DJTobias/UAS_receiver_design/receiver7RP2350V5/receiver_assembly/receiver_panelized/Screenshot from 2025-09-17 13-29-44.png

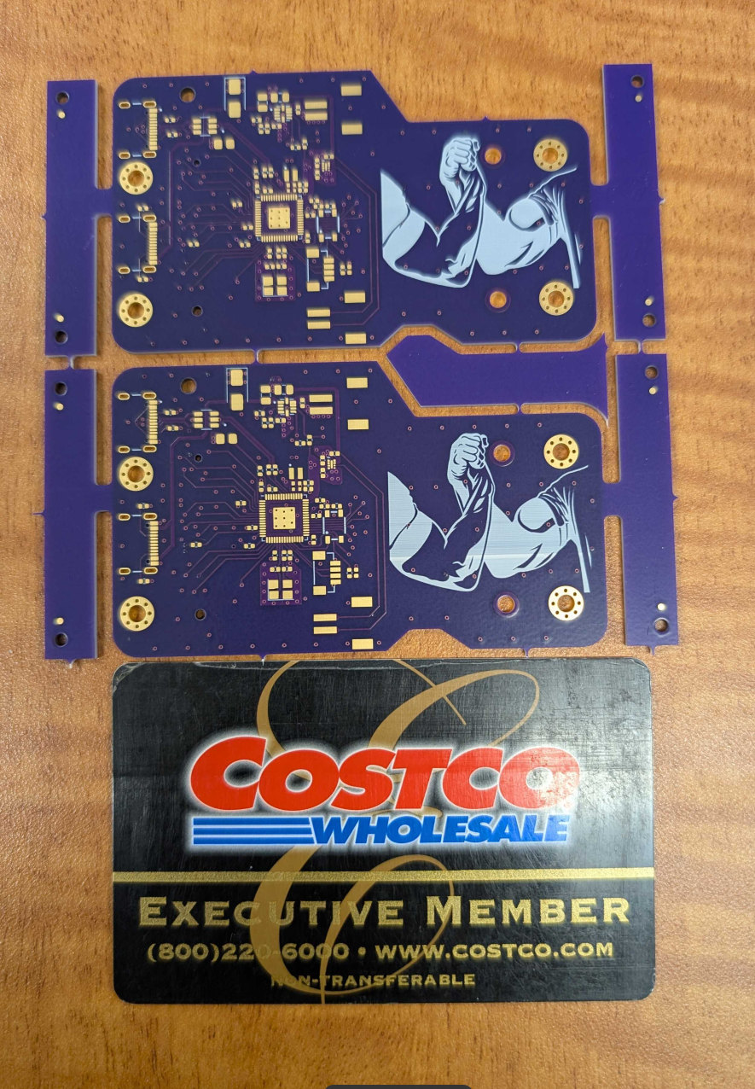
receiver7RP2350V5/receiver_assembly/receiver_panelized/Screenshot from 2025-09-17 13-29-44.png
