DJTobias/UAS_receiver_design/receiver7RP2350V4/receiver_assembly/receiverV4/R4_BOM.xlsx

ITEM # | QUANTITY | REF Des | Description/Value | Mfg Part NUM | Manufacturer | Sourcing | Type | URL/Datasheet
1 | 2 | C20,C21 | CAP CER 15PF 5% 16V 0402 | GJM1555C1H150FB01D | Murata | Vendor source | SMT | https://octopart.com/gjm1555c1h150fb01d-murata-17965865
2 | 2 | C26,C30 | CAP CER 10UF 10% 50V X5R 0805 | GRM21BR61H106KE43L | Murata | Vendor source | SMT | https://octopart.com/grm21br61h106ke43l-murata-52808131
3 | 10 | C3,C6,C7,C9,C10,C15,C22,C23,C27,C28 | CAP CER 4.7UF 10% 10V X5R 0402 | C1005X5R1A475K050BC | TDK | Vendor source | SMT | https://octopart.com/c1005x5r1a475k050bc-tdk-28166959
4 | 15 | C1,C2,C4,C5,C8,C11,C12,C13,C14,C16,C17,C18,C24,C25,C31 | CAP CER 100NF 10% 16V X5R 0402 | CC0402KRX5R7BB104 | Yageo Group | Vendor source | SMT | https://octopart.com/cc0402krx5r7bb104-yageo+group-8376508
5 | 1 | D1 | LED, RED, 0402 | XZMDK68W-2 | SunLED | Vendor source | SMT | https://octopart.com/xzmdk68w-2-sunled-39188860
6 | 1 | D2 | Transient Voltage Suppressor, 6.0V bidirectional, SMA(DO-214AC) | SMAJ6.0CA | Littlefuse | Vendor source | SMT | https://octopart.com/smaj6.0ca-littelfuse-350218
7 | 1 | J1 | JST SH CONN 4pin 1mm spaceing | BM04B-SRSS-TB | JST | Vendor source | SMT | https://octopart.com/bm04b-srss-tb-jst-289151
8 | 2 | J2,J3 | MM60 Stand Off | NT4R1600 | JAE Electronics | Vendor source | SMT | https://octopart.com/nt4r1600-jae+electronics-20362796
9 | 1 | J6 | Conn Mini PCI Express Card Edge SKT 52 POS 0.8mm | MM60-52B1-E1-R650 | JAE Electronics | Vendor source | SMT | https://octopart.com/mm60-52b1-e1-r650-jae+electronics-9561106
10 | 2 | J8,J10 | JST PH CONN 2pin 2mm spacing RIGH ANG | S2B-PH-SM4-TB | JST | Vendor source | SMT | https://octopart.com/s2b-ph-sm4-tb-jst-52244065
11 | 2 | J5,J7 | USB Connector, 24 Contact(s), Female, Right Angle, Solder Terminal, Locking | USB4105-GF-A | Global Connector Technology | Vendor source | SMT | https://octopart.com/usb4105-gf-a-global+connector+technology-107467269
12 | 1 | L1 | IND 3.3uH, 2.3A, 20% | AOTA-B201610S3R3-101-T | Abracon | Vendor source | SMT | https://octopart.com/aota-b201610s3r3-101-t-abracon-159358662
13 | 1 | R20 | RES 330k Ohm 1% 1/16W 0402 | CRCW0402330KFKED | Vishay | Vendor source | SMT | https://octopart.com/crcw0402330kfked-vishay-39868742
14 | 2 | R18, R21 | RES 100k Ohm 1& 1/16W 0402 | CRCW0402100KFKED | Vishay | Vendor source | SMT | https://octopart.com/crcw0402100kfked-vishay-39455035
15 | 2 | R12,R13 | RES 10k Ohm 1% 1/16W 0402 | CRCW040210K0FKEDHP | Vishay | Vendor source | SMT | https://octopart.com/crcw040210k0fkedhp-vishay-44321076
16 | 4 | R8,R10,R15,R16 | RES 5.1k Ohm 1% 1/16W 0402 | CRCW04025K10FKED | Vishay | Vendor source | SMT | https://octopart.com/crcw04025k10fked-vishay-39831117
17 | 2 | R14,R19 | RES 3.3k Ohm 5% 1/16W 0402 | CRCW04023K30JNEDC | Vishay | Vendor source | SMT | https://octopart.com/crcw04023k30jnedc-vishay-23798202
18 | 4 | R1,R2,R6,R11 | RES 1k Ohm 5% 1/16W 0402 | CRCW04021K00FKED | Vishay | Vendor source | SMT | https://octopart.com/crcw04021k00fked-vishay-39455913
19 | 1 | R7 | RES 33 Ohm 1% 1/5W 0402 | CRCW040233R0FKEDHP | Vishay | Vendor source | SMT | https://octopart.com/crcw040233r0fkedhp-vishay-44383092
20 | 2 | R3,R4 | RES 27 Ohm 1% 1/5W 0402 | CRCW040227R0FKEDHP | Vishay | Vendor source | SMT | https://octopart.com/crcw040227r0fkedhp-vishay-44387812
21 | 1 | S1 | Tactile Switch, 0.05A, 16Vdc, | 434133025816 | Wurth Elektronik | Vendor source | SMT | https://octopart.com/434133025816-wurth+elektronik-99472342
22 | 1 | U1 | RP2354 60-QFN (7x7) SC | SC1511 | Rasberry Pi | Vendor source | SMT | https://www.digikey.com/en/products/detail/raspberry-pi/SC1511-A4/28172162
23 | 1 | U2 | USBLC6-2SC6 | USBLC6-2SC6 | STMicroelectronics | Vendor source | SMT | https://octopart.com/usblc6-2sc6-stmicroelectronics-39666276
24 | 1 | U5 | 3.3V, 1 A, LDO Regulator, XDFN8-1216 | NCP186AMX330TAG | Onsemi | Vendor source | SMT | https://octopart.com/ncp186amx330tag-onsemi-61522627
25 | 1 | U4 | MP2664GG-0000-Z | MP2664GG-0000-Z | Monolithic Power Systems | Vendor source | SMT | https://octopart.com/mp2664gg-0000-z-monolithic+power+systems-105831035
26 | 1 | Y1 | Crystal Oscillator 12MHz | ABM8-272-T3 | Abracon | Vendor source | SMT | https://octopart.com/abm8-272-t3-abracon-145972461
