DJTobias/UAS_receiver_design/receiver7RP2350V5/receiver_assembly/receiver_files_v2/receiver_top_image.png

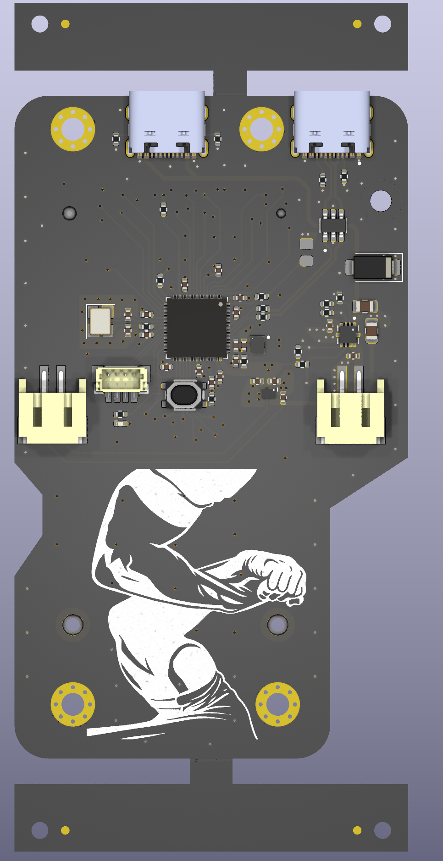
receiver7RP2350V5/receiver_assembly/receiver_files_v2/receiver_top_image.png
