DJTobias/UAS_receiver_design/receiver7RP2350V5/receiver_assembly/receiver/receiver7RP2350V5.pdf

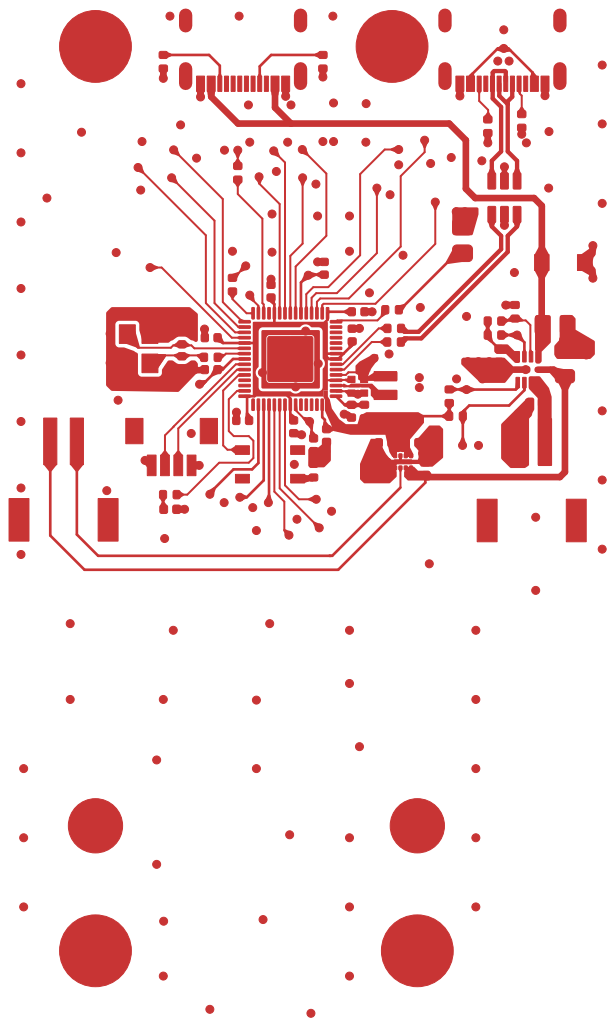
[picture p4: page 1]

Id: 1/11 Title: File: receiver7RP2350V2.kicad_pcb Sheet:

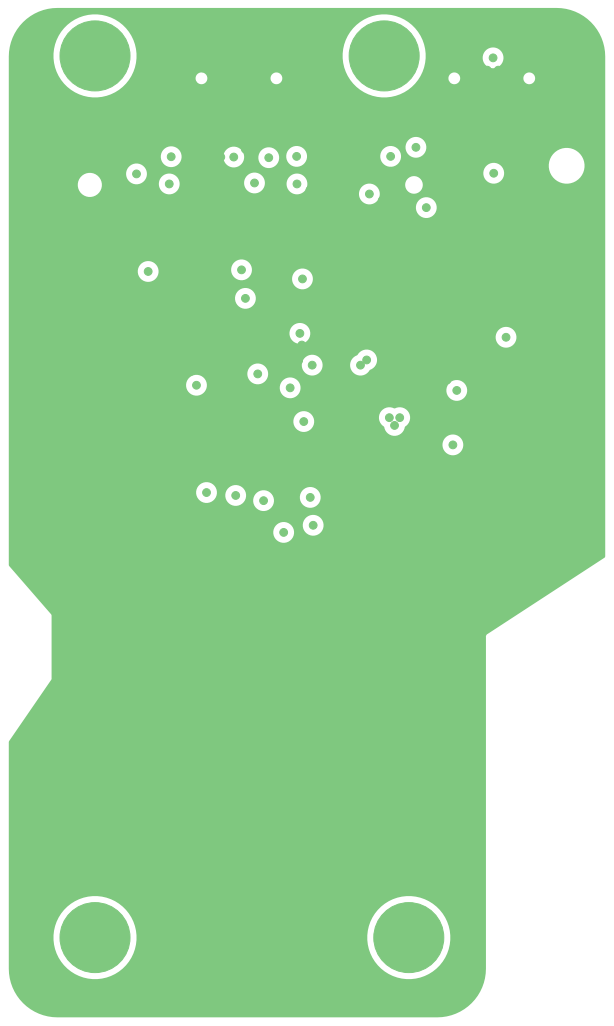
[picture p5: page 2]

Id: 2/11 Title: File: receiver7RP2350V2.kicad_pcb Sheet:

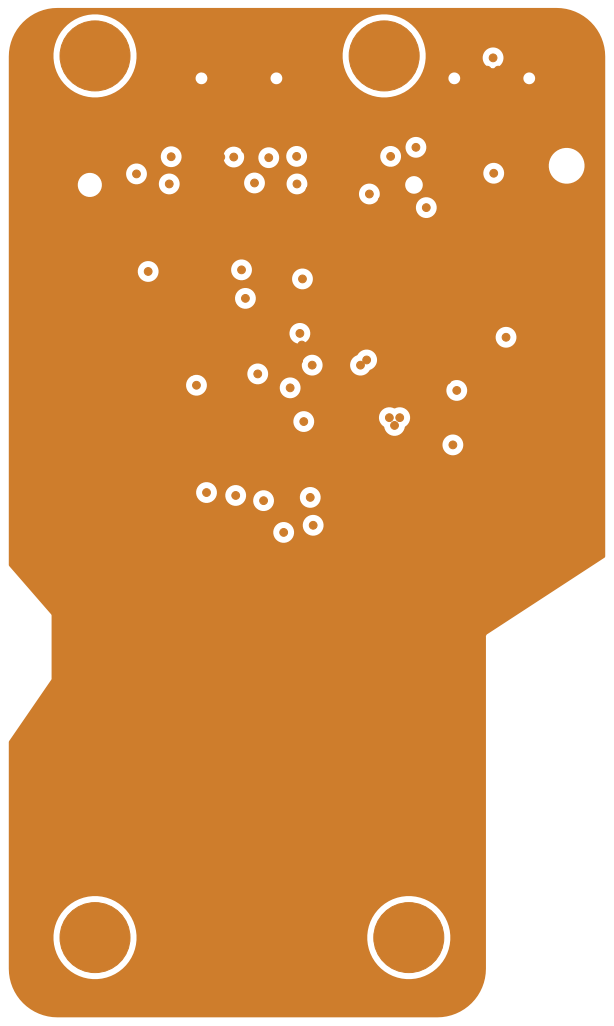
[picture p6: page 3]

Id: 3/11 Title: File: receiver7RP2350V2.kicad_pcb Sheet:

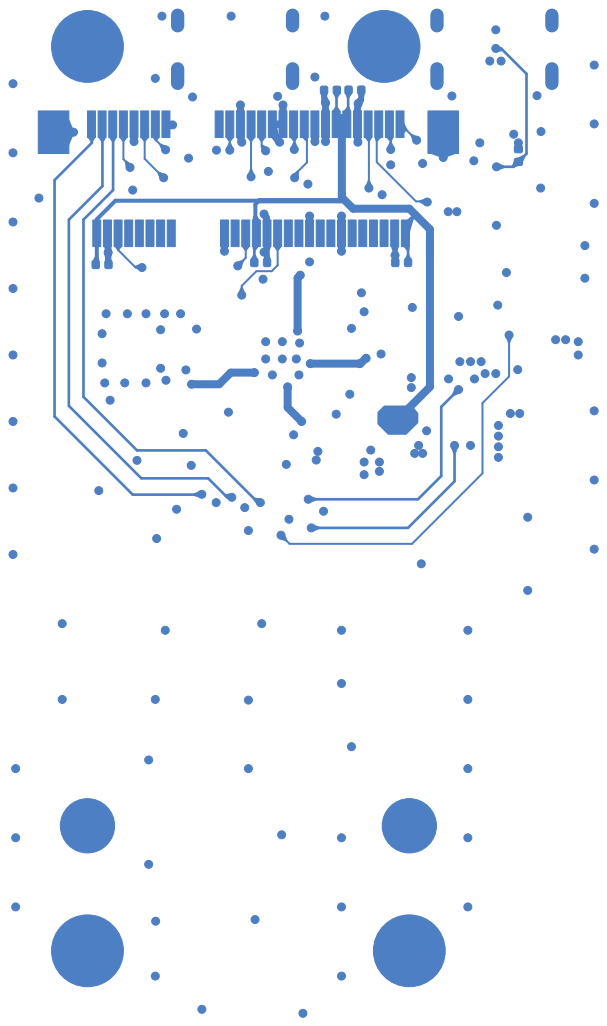
[picture p7: page 4]

Id: 4/11 Title: File: receiver7RP2350V2.kicad_pcb Sheet:

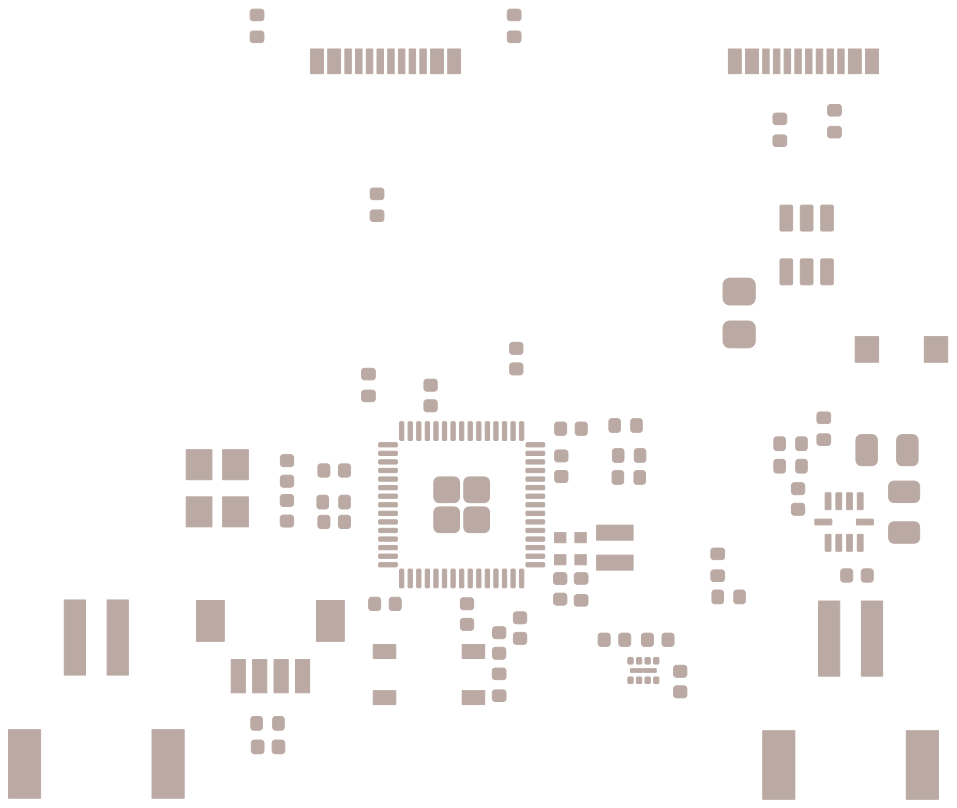
[picture p8: page 5]

Id: 5/11 Title: File: receiver7RP2350V2.kicad_pcb Sheet:

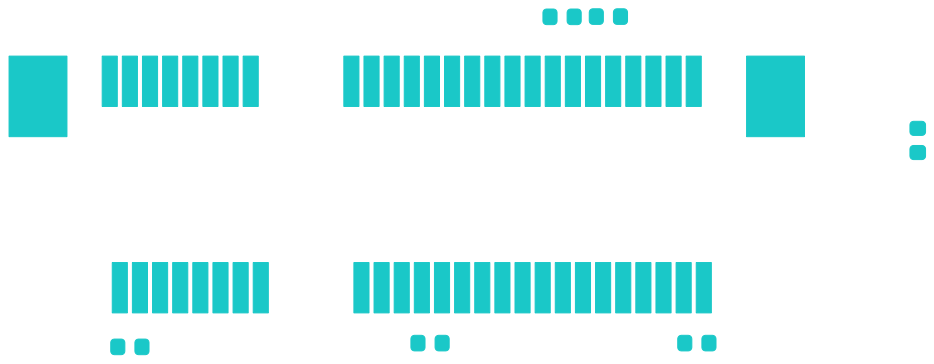
[picture p9: page 6]

Id: 6/11 Title: File: receiver7RP2350V2.kicad_pcb Sheet:

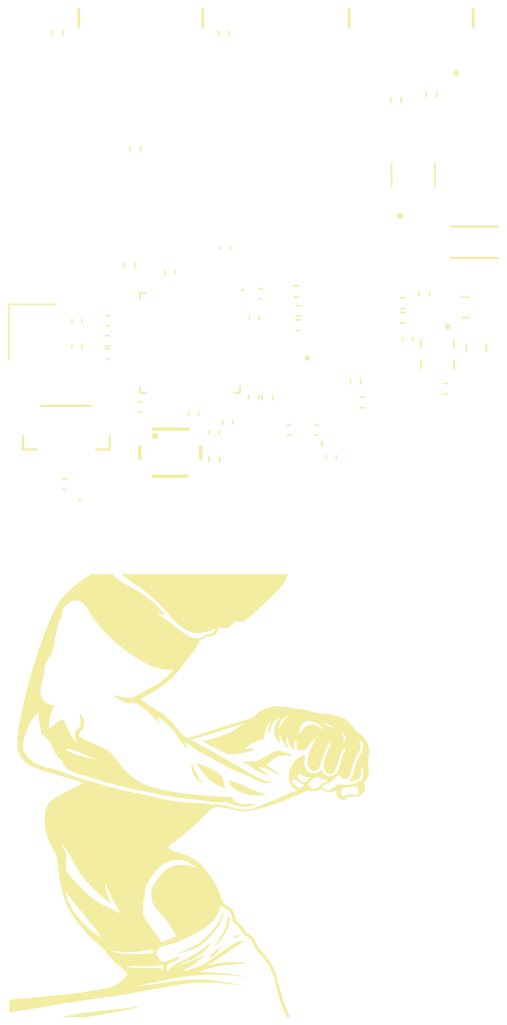
[picture p10: page 7]

Id: 7/11 Title: File: receiver7RP2350V2.kicad_pcb Sheet:

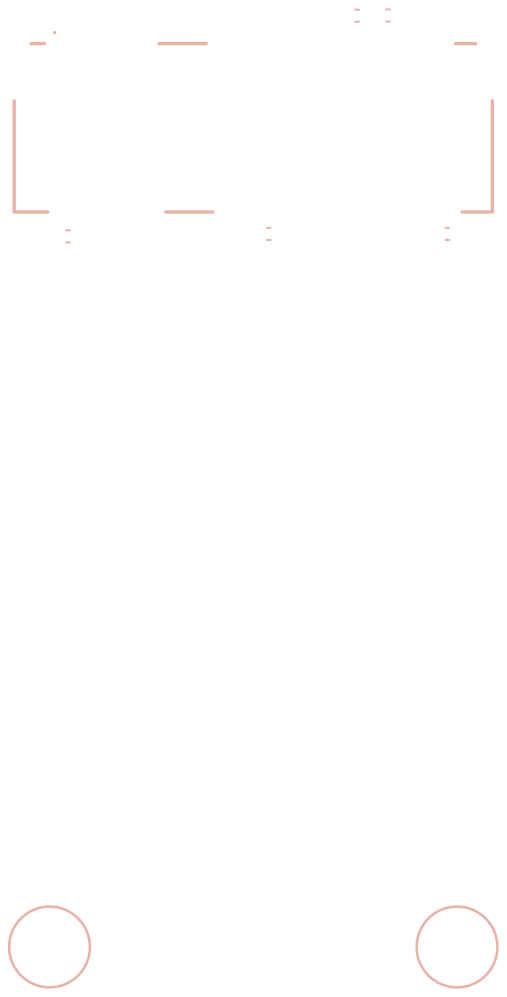
[picture p11: page 8]

Id: 8/11 Title: File: receiver7RP2350V2.kicad_pcb Sheet:

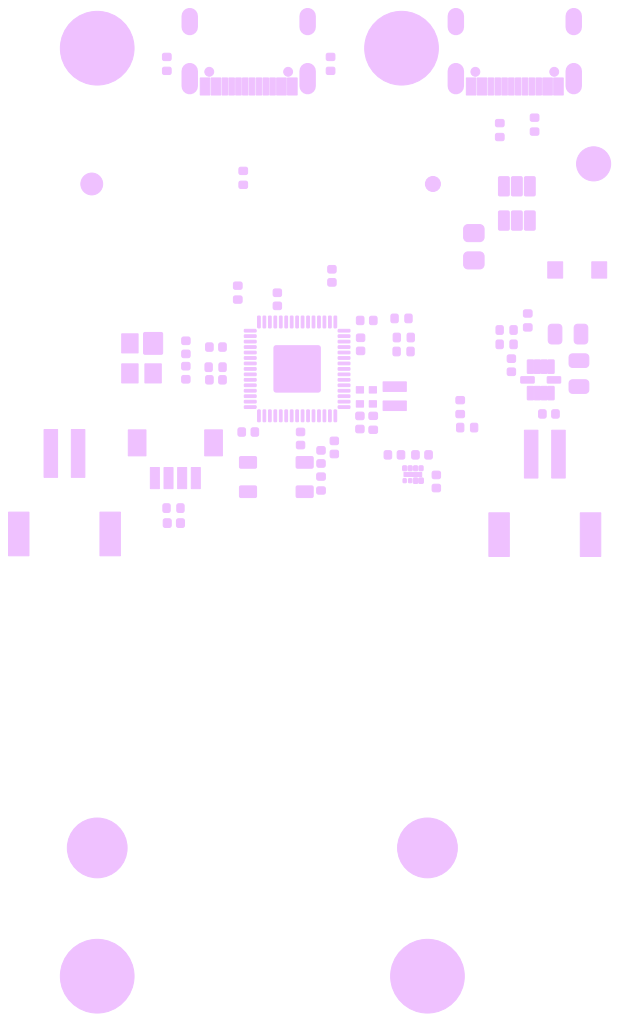
[picture p12: page 9]

Id: 9/11 Title: File: receiver7RP2350V2.kicad_pcb Sheet:

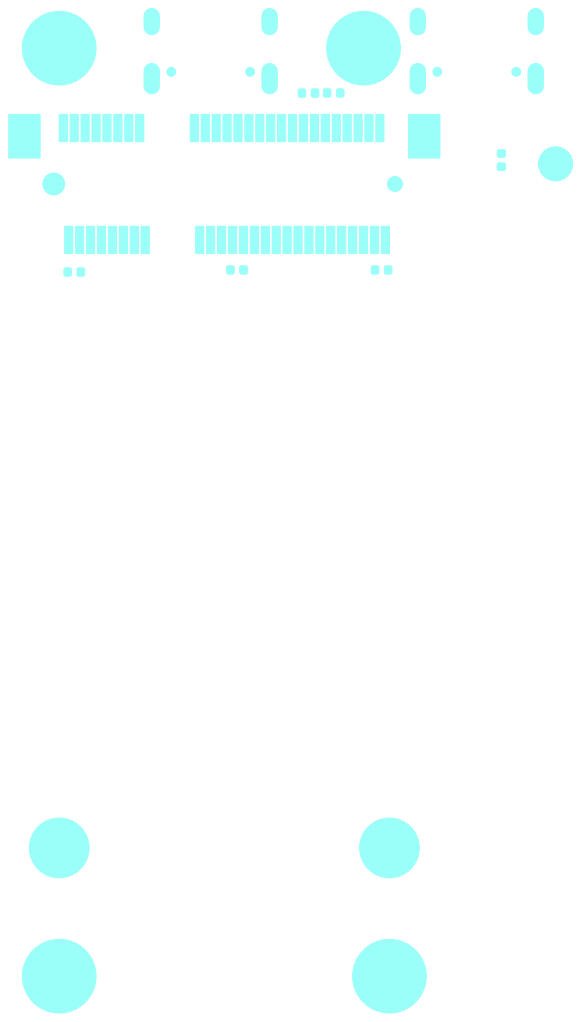
[picture p13: page 10]

Id: 10/11 Title: File: receiver7RP2350V2.kicad_pcb Sheet:

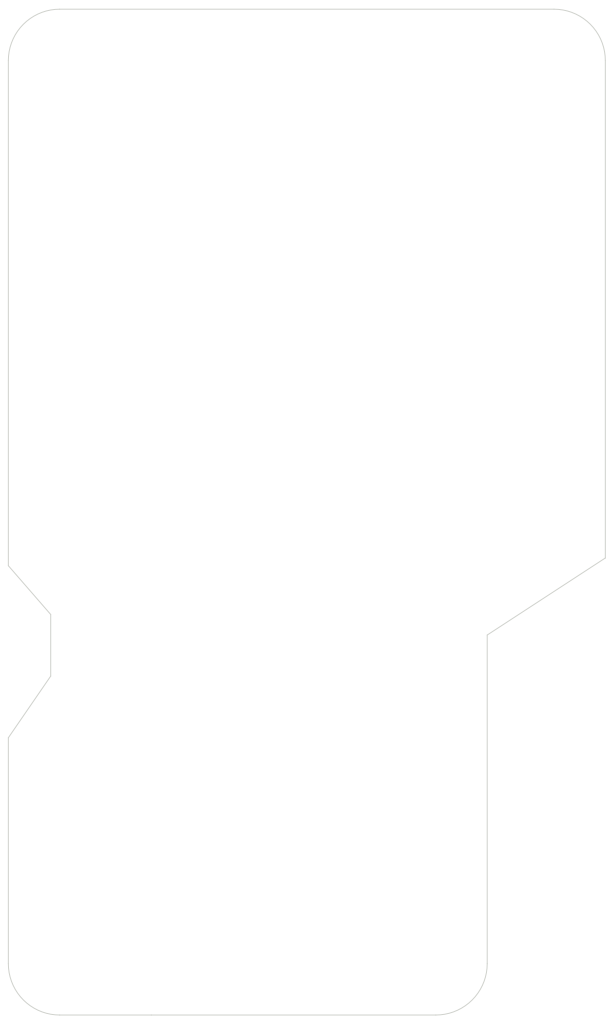
[picture p14: page 11]

Id: 11/11 Title: File: receiver7RP2350V2.kicad_pcb Sheet:
