DJTobias/UAS_receiver_design/receiver7RP2350V5/receiver7RP2350V5.kicad_pcb

## KiCad design receiver7RP2350V5/receiver7RP2350V5.kicad_pcb (2026-05-14)

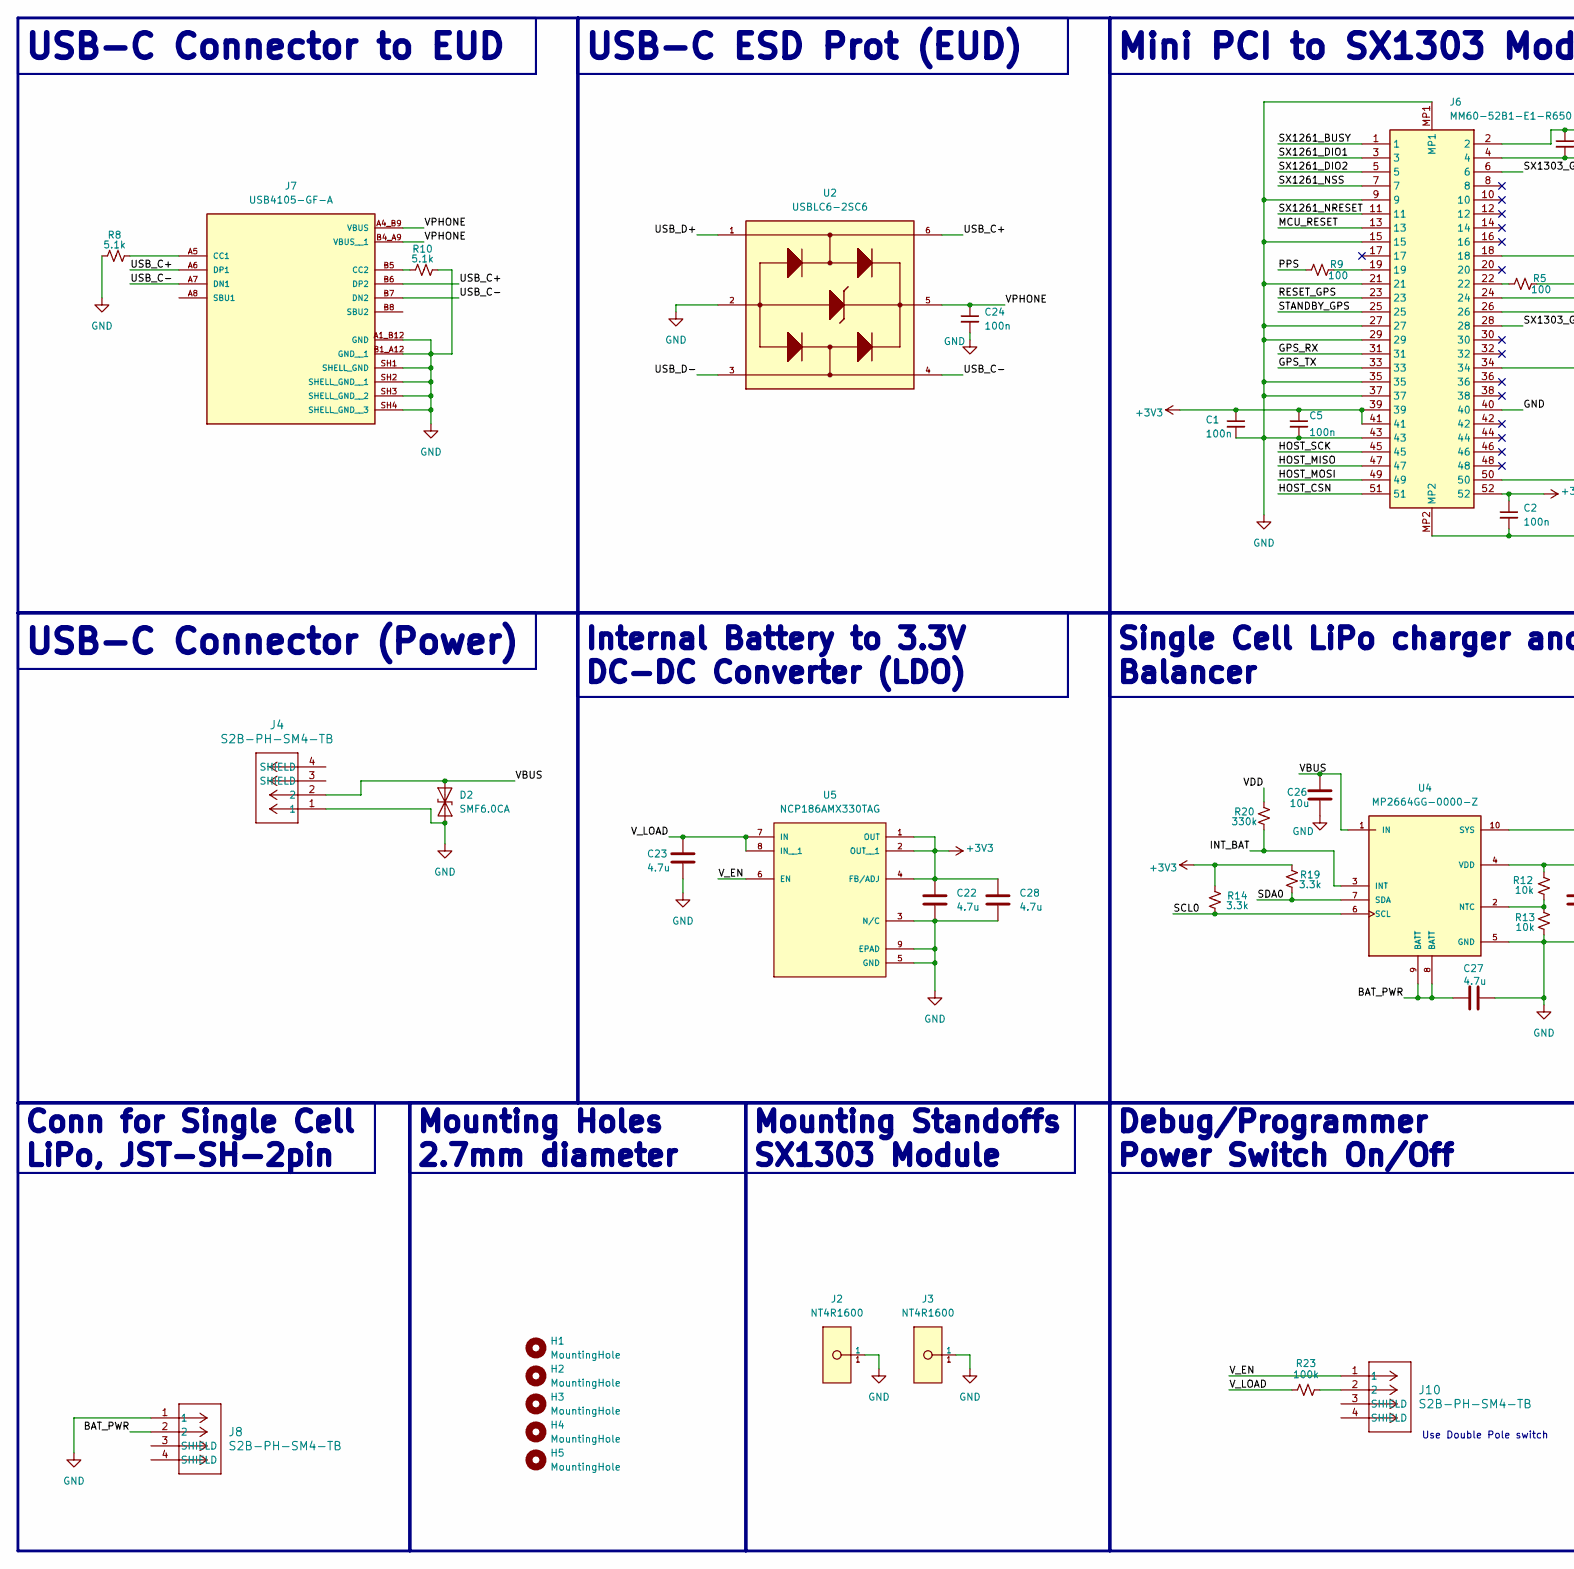
[picture p15: schematic receiver7RP2350V5.kicad_sch, Handshake Receiver V3, part in row 1, column 1]

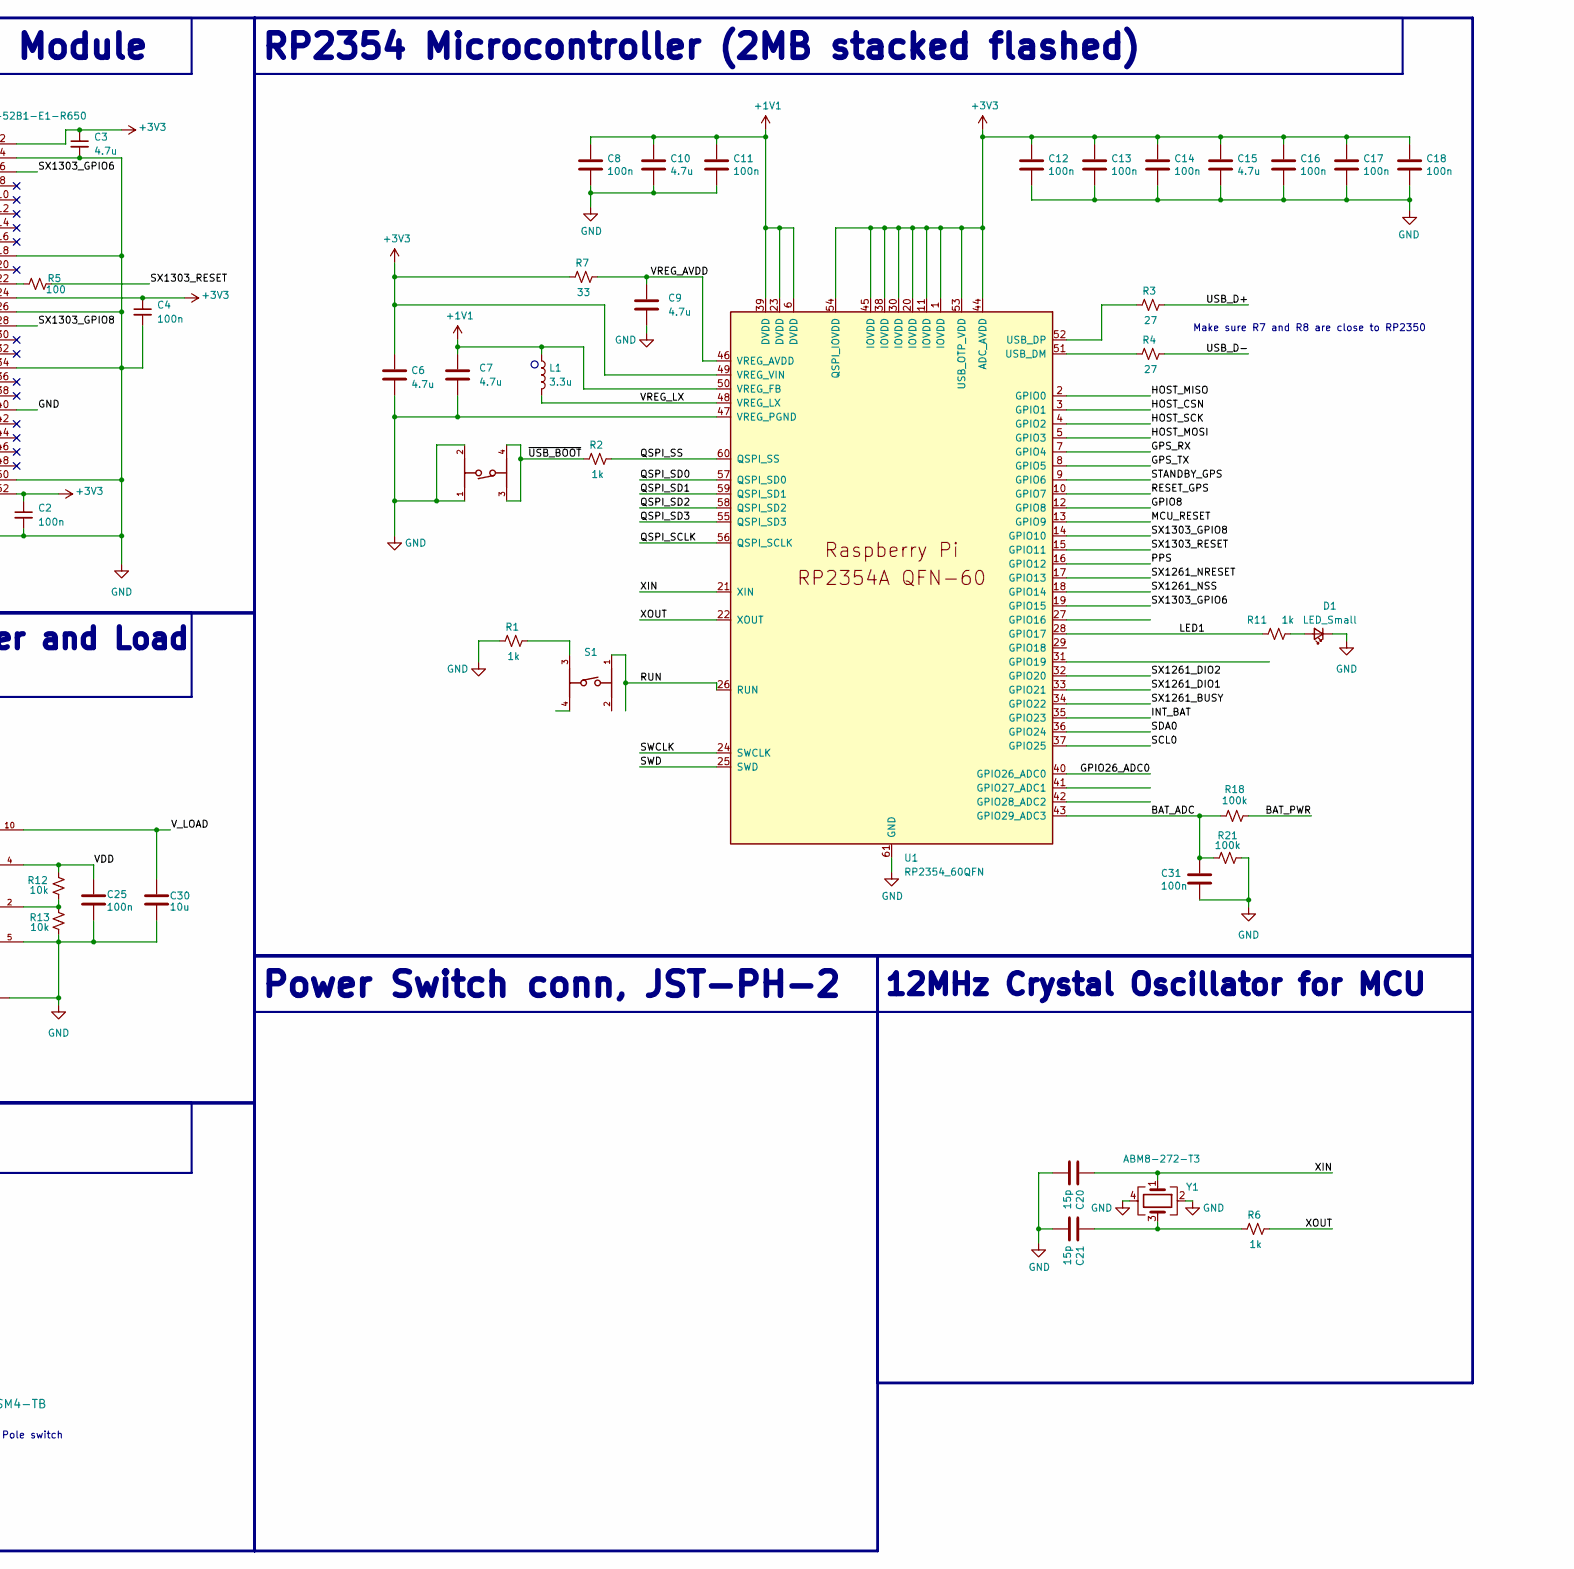
[picture p16: schematic receiver7RP2350V5.kicad_sch, Handshake Receiver V3, part in row 1, column 2]

Parts:
C1, C2, C4, C5, C8, C11, C12, C13, C14, C16, C17, C18, C24, C25, C31: 100n; C_0402_1005Metric
C3, C9, C10, C15, C22, C23, C27, C28: 4.7u; C_0402_1005Metric
C6, C7: 4.7u; C_0402_1005Metric_small_pads
C20, C21: 15p; C_0402_1005Metric
C26, C30: 10u; C_0805_2012Metric
D1: LED_Small; LED_0402_1005Metric
D2: SMF6.0CA; SMF26CA_Custom
H1: MountingHole; MountingHole_2.5mm
H2, H3, H4, H5: MountingHole; MountingHole_2.7mm_M2.5_Pad_Via
J2, J3: NT4R1600; JAE_Electronics-NT4R1600-MFG; mouser part number 656-NT4R1600; digikey description STANDOFF FOR MM60 SERIES
J4, J8, J10: S2B-PH-SM4-TB; CONN_S2B-PH-SM4-TB_JST_mod2
J6: MM60-52B1-E1-R650; MM6052B1E1R650_mod_screw; Mouser Part Number 656-MM60-52B1-E1-R
J7: USB4105-GF-A; GCT_USB4105-GF-A; PARTREV B4
L1: 3.3u; L_pol_2016
R1, R2, R6, R11: 1k; R_0402_1005Metric
R3, R4: 27; R_0402_1005Metric
R5, R9: 100; R_0402_1005Metric
R7: 33; R_0402_1005Metric
R8, R10: 5.1k; R_0402_1005Metric
R12, R13: 10k; R_0402_1005Metric
R14, R19: 3.3k; R_0402_1005Metric
R18, R21, R23: 100k; R_0402_1005Metric
R20: 330k; R_0402_1005Metric
S1, S2: 434133025816; 434133025816_mod
U1: RP2354_60QFN; RP2350-QFN-60-1EP_7x7_P0.4mm_EP3.4x3.4mm_ThermalVias
U2: USBLC6-2SC6; SOT95P280X145-6N
U4: MP2664GG-0000-Z; QFN50P200X200X105-10N; PARTREV 1.01
U5: NCP186AMX330TAG; PSON40P160X120X45-9N; PARTREV Rev.5
Y1: ABM8-272-T3; Crystal_SMD_3225-4Pin_3.2x2.5mm

Connections:
+1V1: C7.1, C8.1, C10.1, C11.1, L1.1, U1.6 (DVDD), U1.23 (DVDD), U1.39 (DVDD), U1.50 (VREG_FB)
+3V3: C1.1, C2.1, C3.1, C4.1, C5.1, C6.1, C12.1, C13.1, C14.1, C15.1, C16.1, C17.1, C18.1, C22.1, C28.1, J6.2, J6.24, J6.39, J6.41, J6.52, R7.1, R14.2, R19.2, U1.1 (IOVDD), U1.11 (IOVDD), U1.20 (IOVDD), U1.30 (IOVDD), U1.38 (IOVDD), U1.44 (ADC_AVDD), U1.45 (IOVDD), U1.49 (VREG_VIN), U1.53 (USB_OTP_VDD), U1.54 (QSPI_IOVDD), U5.1 (OUT), U5.2 (OUT__1), U5.4 (FB/ADJ)
/BAT_ADC: C31.1, R18.2, R21.2, U1.43 (GPIO29_ADC3)
/BAT_PWR: C27.1, J8.2, R18.1, U4.8 (BATT), U4.9 (BATT)
/GPIO8: U1.12 (GPIO8)
/GPIO26_ADC0: U1.40 (GPIO26_ADC0)
/GPS_RX: J6.31, U1.7 (GPIO4)
/GPS_TX: J6.33, U1.8 (GPIO5)
/HOST_CSN: J6.51, U1.3 (GPIO1)
/HOST_MISO: J6.47, U1.2 (GPIO0)
/HOST_MOSI: J6.49, U1.5 (GPIO3)
/HOST_SCK: J6.45, U1.4 (GPIO2)
/INT_BAT: R20.1, U1.35 (GPIO23), U4.3 (INT)
/LED1: R11.1, U1.28 (GPIO17)
/MCU_RESET: J6.13, U1.13 (GPIO9)
/PPS: R9.1, U1.16 (GPIO12)
/QSPI_SCLK: U1.56 (QSPI_SCLK)
/QSPI_SD0: U1.57 (QSPI_SD0)
/QSPI_SD1: U1.59 (QSPI_SD1)
/QSPI_SD2: U1.58 (QSPI_SD2)
/QSPI_SD3: U1.55 (QSPI_SD3)
/QSPI_SS: R2.2, U1.60 (QSPI_SS)
/RESET_GPS: J6.23, U1.10 (GPIO7)
/RUN: S1.1, U1.26 (RUN)
/SCL0: R14.1, U1.37 (GPIO25), U4.6 (SCL)
/SDA0: R19.1, U1.36 (GPIO24), U4.7 (SDA)
/STANDBY_GPS: J6.25, U1.9 (GPIO6)
/SWCLK: U1.24 (SWCLK)
/SWD: U1.25 (SWD)
/SX1261_BUSY: J6.1, U1.34 (GPIO22)
/SX1261_DIO1: J6.3, U1.33 (GPIO21)
/SX1261_DIO2: J6.5, U1.32 (GPIO20)
/SX1261_NRESET: J6.11, U1.17 (GPIO13)
/SX1261_NSS: J6.7, U1.18 (GPIO14)
/SX1303_GPIO6: J6.6, U1.19 (GPIO15)
/SX1303_GPIO8: J6.28, U1.14 (GPIO10)
/SX1303_RESET: R5.2, U1.15 (GPIO11)
/USB_C+: J7.A6 (DP1), J7.B6 (DP2), U2.6
/USB_C-: J7.A7 (DN1), J7.B7 (DN2), U2.4
/USB_D+: R3.2, U2.1
/USB_D-: R4.2, U2.3
/VBUS: C26.1, D2.2 (A2), J4.2, U4.1 (IN)
/VDD: C25.1, R12.2, R20.2, U4.4 (VDD)
/VPHONE: C24.1, J7.A4_B9 (VBUS), J7.B4_A9 (VBUS__1), U2.5
/VREG_AVDD: C9.1, R7.2, U1.46 (VREG_AVDD)
/VREG_LX: L1.2, U1.48 (VREG_LX)
/V_EN: J10.1, U5.6 (EN)
/V_LOAD: C23.1, C30.1, R23.2, U4.10 (SYS), U5.7 (IN), U5.8 (IN__1)
/XIN: C20.1, U1.21 (XIN), Y1.1
/XOUT: R6.2, U1.22 (XOUT)
/~USB_BOOT: R2.1, S2.3, S2.4
GND: C1.2, C2.2, C3.2, C4.2, C5.2, C6.2, C7.2, C8.2, C9.2, C10.2, C11.2, C12.2, C13.2, C14.2, C15.2, C16.2, C17.2, C18.2, C20.2, C21.2, C22.2, C23.2, C24.2, C25.2, C26.2, C27.2, C28.2, C30.2, C31.2, D1.1 (K), D2.1 (A1), J2.1, J3.1, J4.1, J6.4, J6.9, J6.15, J6.18, J6.21, J6.26, J6.27, J6.29, J6.34, J6.35, J6.37, J6.40, J6.43, J6.50, J6.MP1, J6.MP2, J7.A1_B12 (GND), J7.B1_A12 (GND__1), J7.SH1 (SHELL_GND), J7.SH2 (SHELL_GND__1), J7.SH3 (SHELL_GND__2), J7.SH4 (SHELL_GND__3), J8.1, R1.1, R8.1, R10.2, R13.1, R21.1, S2.1, S2.2, U1.47 (VREG_PGND), U1.61 (GND), U2.2, U4.5 (GND), U5.3 (N/C), U5.5 (GND), U5.9 (EPAD), Y1.2, Y1.4
unnamed: C21.1, R6.1, Y1.3
unnamed: D1.2 (A), R11.2
unnamed: J6.19, R9.2
unnamed: J6.22, R5.1
unnamed: J7.A5 (CC1), R8.2
unnamed: J7.B5 (CC2), R10.1
unnamed: J10.2, R23.1
unnamed: R1.2, S1.3
unnamed: R4.1, U1.51 (USB_DM)
unnamed: R3.1, U1.52 (USB_DP)
unnamed: R12.1, R13.2, U4.2 (NTC)

Notes on the sheet:
Use Double Pole switch
Make sure R7 and R8 are close to RP2350
12MHz Crystal Oscillator for MCU
Debug/Programmer Power Switch On/Off
Conn for Single Cell LiPo, JST-SH-2pin
USB-C Connector (Power)
Power Switch conn, JST-PH-2
Mini PCI to SX1303 Module
USB-C ESD Prot (EUD)
Mounting Holes 2.7mm diameter
Single Cell LiPo charger and Load Balancer
Internal Battery to 3.3V DC-DC Converter (LDO)
Mounting Standoffs SX1303 Module
USB-C Connector to EUD
RP2354 Microcontroller (2MB stacked flashed)

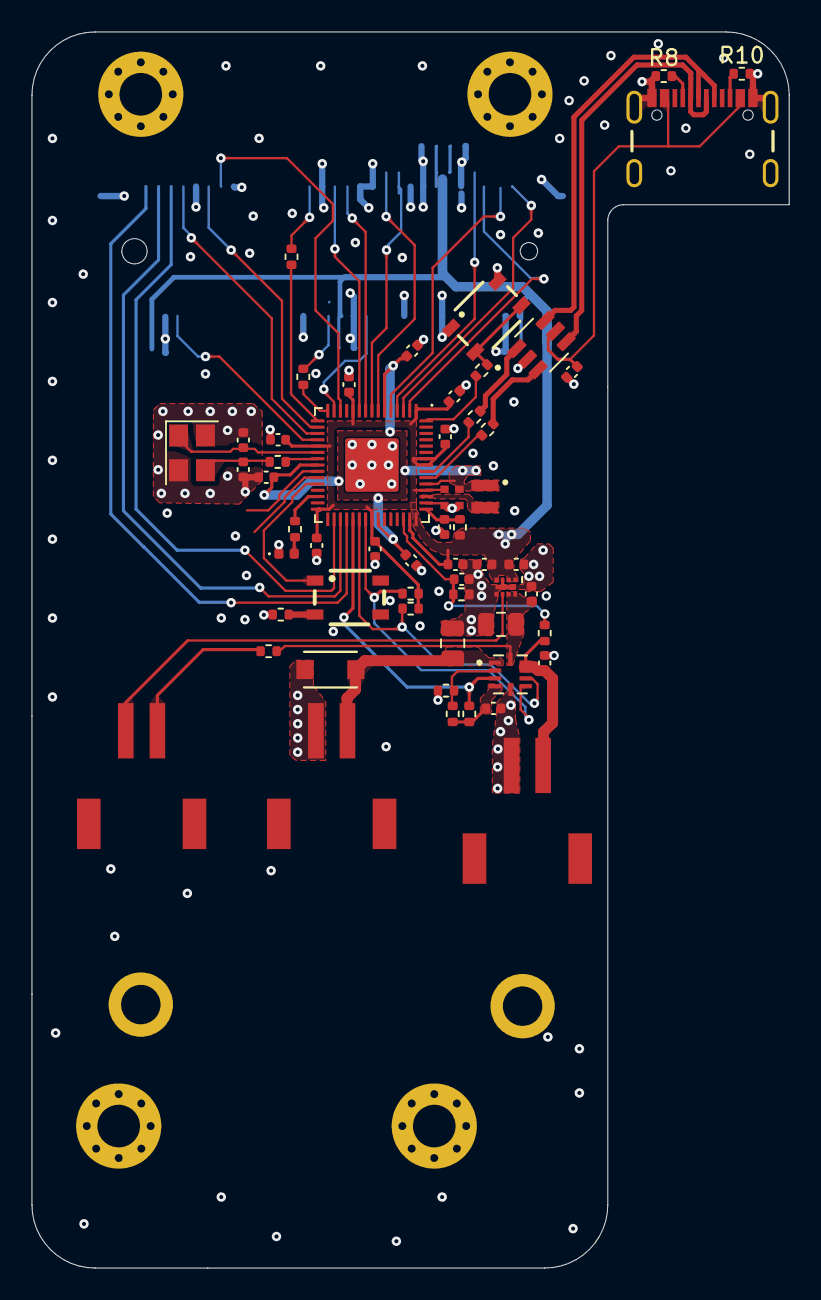
[picture p17: board receiver7RP2350V5.kicad_pcb from above]

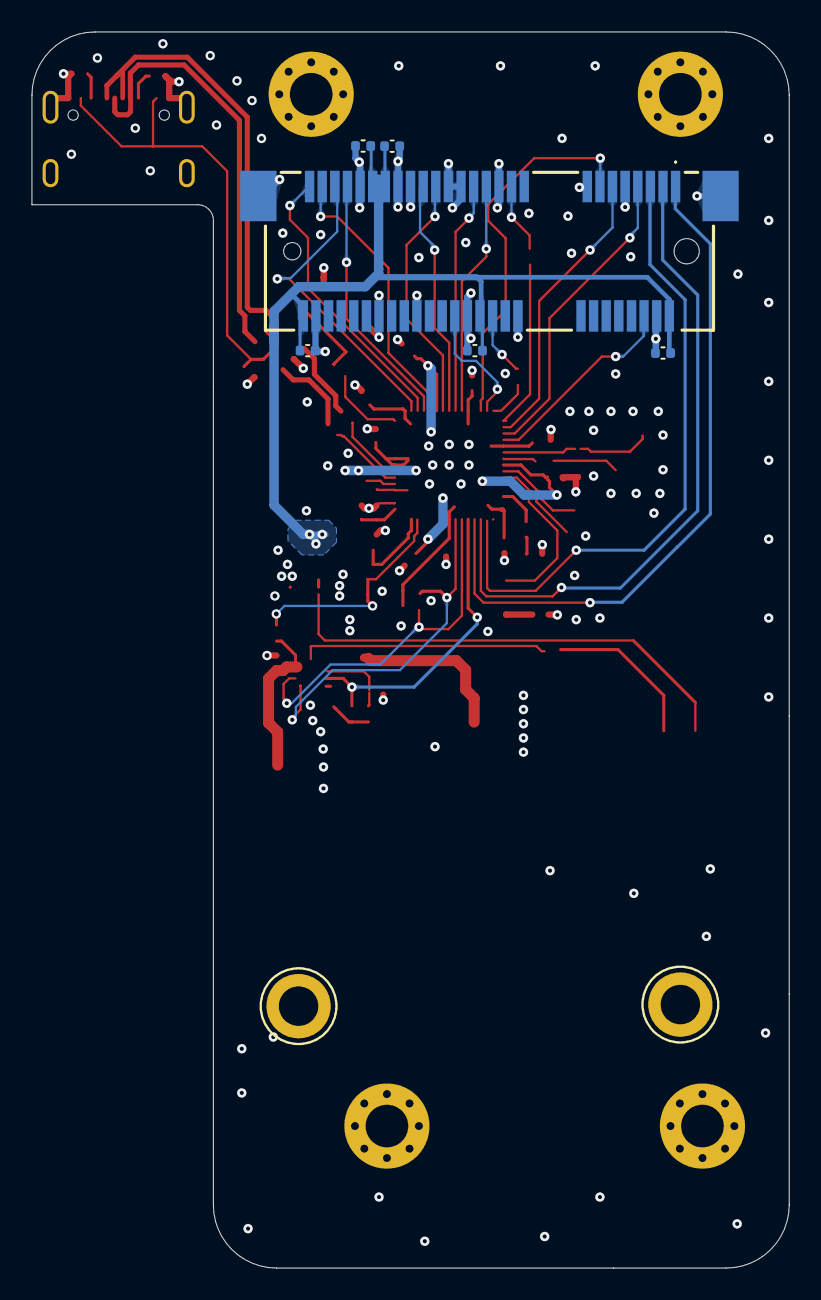
[picture p18: board receiver7RP2350V5.kicad_pcb from below]

Board: 4 copper layers, 48.0 x 78.3 mm, 70 parts (8 on the bottom side), 54 nets.
