DJTobias/UAS_receiver_design/receiverV6/receiverV6.kicad_pcb

## KiCad design receiverV6/receiverV6.kicad_pcb (2025-08-22)

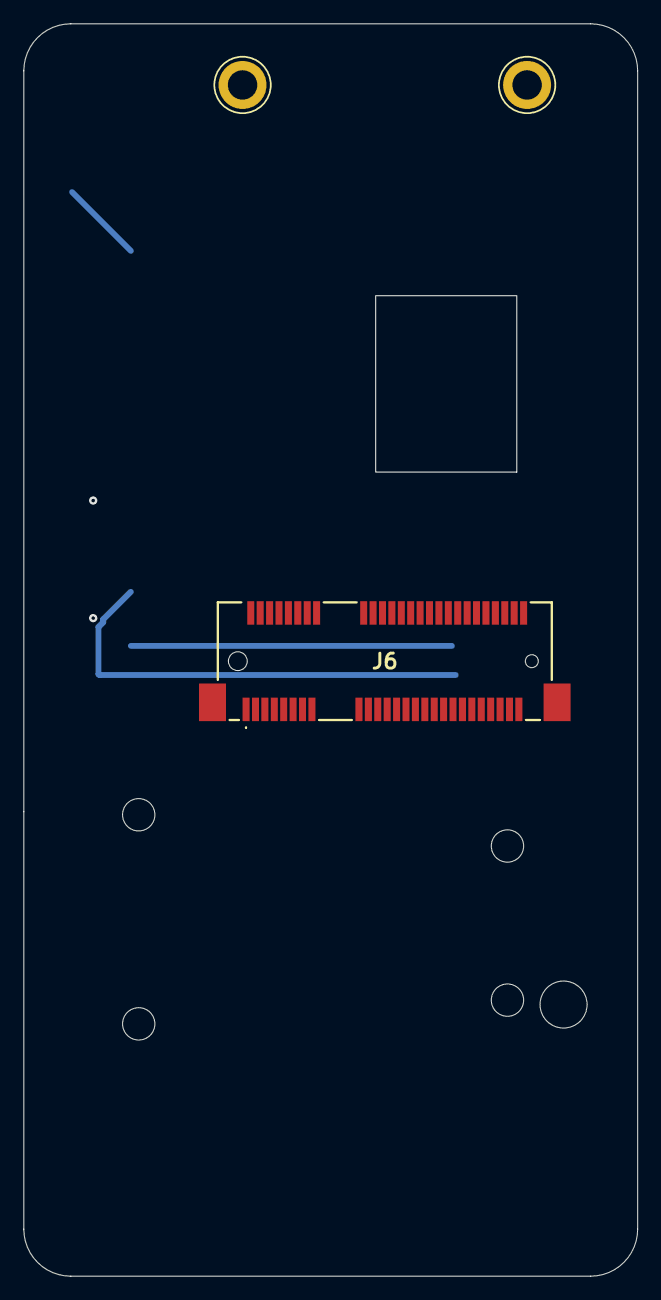
[picture p21: board receiverV6.kicad_pcb from above]

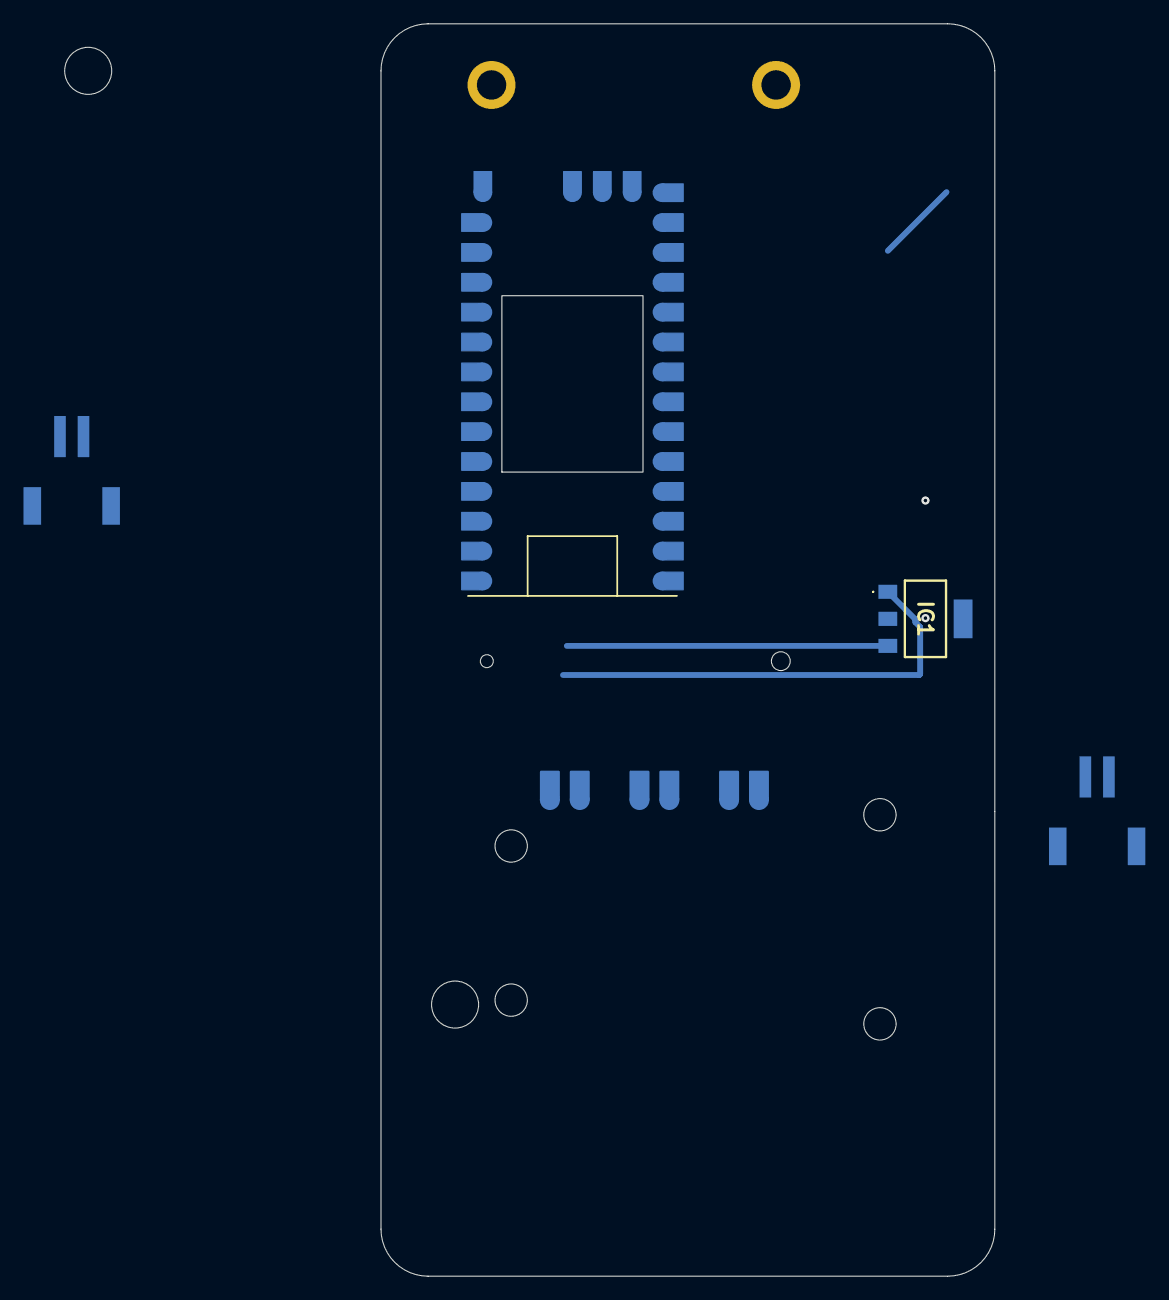
[picture p22: board receiverV6.kicad_pcb from below]

Board: 4 copper layers, 52.2 x 106.5 mm, 10 parts (5 on the bottom side), 9 nets.

Parts:
H5, H6, H7, H8: MountingHole; MountingHole_4mm_t4
IC1: AP7361C-33E-13; AP7361C33E13
J2: adafruitpwr1000; adafruit powerboost 1000 5pinpads
J3, J4: S2B-PH-SM4-TB; CONN_S2B-PH-SM4-TB_JST_mod2
J6: MM60-52B1-E1-R650; MM6052B1E1R650
U1: Teensy4.0; Teensy40_smd_mod_receiver

Connections:
+3.3V: IC1.3 (OUT), J6.2, J6.24, J6.39, J6.41, J6.52
+5V: IC1.1 (IN), J2.8 (5V)
/HOST_CSN: J6.51, U1.12 (10_CS_MQSR)
/HOST_MISO: J6.47, U1.14 (12_MISO_MQSL)
/HOST_MOSI: J6.49, U1.13 (11_MOSI_CTX1)
/HOST_SCK: J6.45, U1.20 (13_SCK_CRX1_LED)
/SX1261_NRESET: J6.11, J6.13
/VBUS: J2.1 (USB_PWR), J3.2
GND: J2.5 (GND), J2.7 (GND), J3.1, J4.1, J6.4, J6.9, J6.15, J6.18, J6.21, J6.26, J6.27, J6.29, J6.34, J6.35, J6.37, J6.40, J6.43, J6.50, J6.MP1, J6.MP2
