DJTobias/UAS_receiver_design/receiverV5/receiverV5.kicad_pcb

## KiCad design receiverV5/receiverV5.kicad_pcb (2025-07-23, an earlier design)

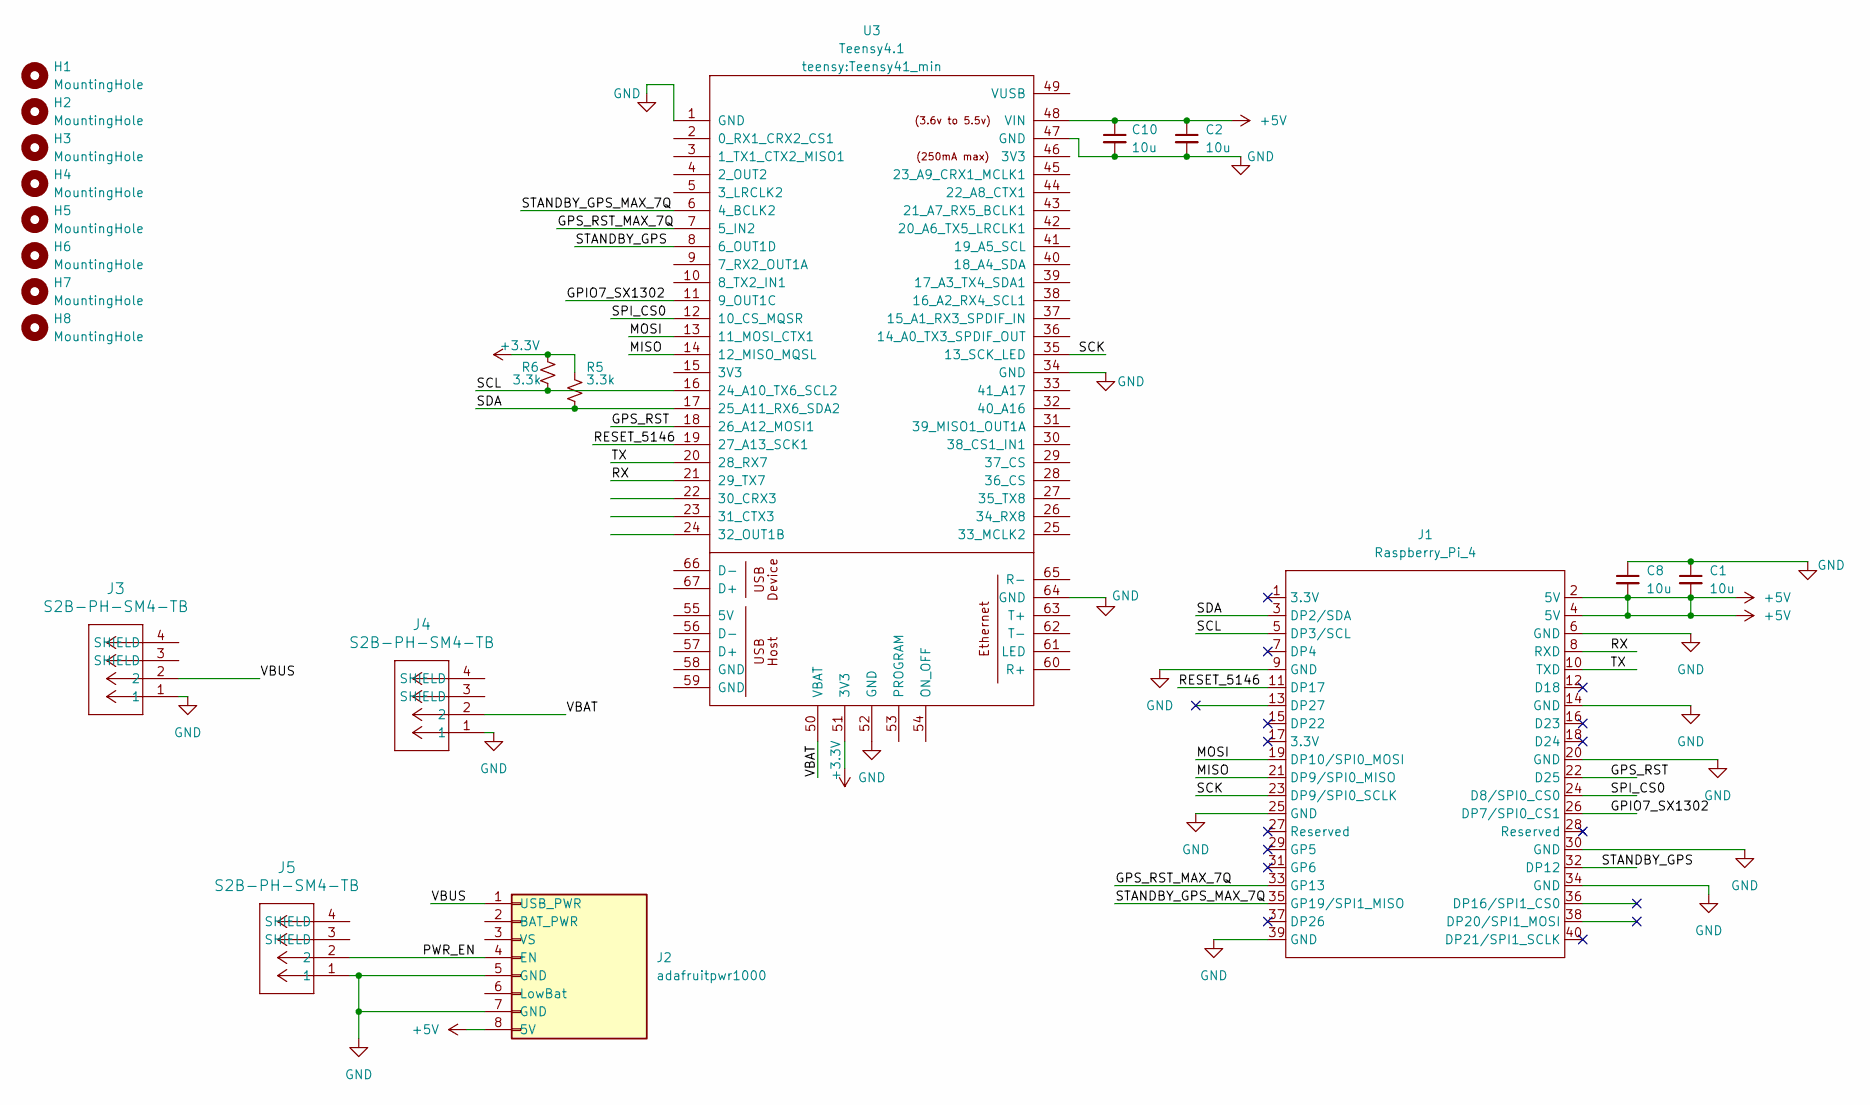
[picture p23: schematic receiverV5.kicad_sch]

Parts:
C1, C2, C8, C10: 10u; C_1206_3216Metric_Pad1.33x1.80mm_HandSolder
H1, H2, H3, H4: MountingHole; mountinghole3mm
H5: MountingHole; MountingHole_4mm_t4
H6, H7, H8: MountingHole; mountinghole4mm
J1: Raspberry_Pi_4; PinHeader_2x20_P2.54mm_Vertical
J2: adafruitpwr1000; adafruit powerboost 1000
J3, J4, J5: S2B-PH-SM4-TB; CONN_S2B-PH-SM4-TB_JST_mod2
R5, R6: 3.3k; R_1206_3216Metric_Pad1.30x1.75mm_HandSolder
U3: Teensy4.1; Teensy41_min

Connections:
+3.3V: R5.1, R6.1, U3.51 (3V3)
+5V: C1.2, C2.1, C8.2, C10.1, J1.2 (5V), J1.4 (5V), J2.8 (5V), U3.48 (VIN)
/GPIO7_SX1302: J1.26 (DP7/SPI0_CS1), U3.11 (9_OUT1C)
/GPS_RST: J1.22 (D25), U3.18 (26_A12_MOSI1)
/GPS_RST_MAX_7Q: J1.33 (GP13), U3.7 (5_IN2)
/MISO: J1.21 (DP9/SPI0_MISO), U3.14 (12_MISO_MQSL)
/MOSI: J1.19 (DP10/SPI0_MOSI), U3.13 (11_MOSI_CTX1)
/PWR_EN: J2.4 (EN), J5.2
/RESET_5146: J1.11 (DP17), U3.19 (27_A13_SCK1)
/RX: J1.8 (RXD), U3.21 (29_TX7)
/SCK: J1.23 (DP9/SPI0_SCLK), U3.35 (13_SCK_LED)
/SCL: J1.5 (DP3/SCL), R6.2, U3.16 (24_A10_TX6_SCL2)
/SDA: J1.3 (DP2/SDA), R5.2, U3.17 (25_A11_RX6_SDA2)
/SPI_CS0: J1.24 (D8/SPI0_CS0), U3.12 (10_CS_MQSR)
/STANDBY_GPS: J1.32 (DP12), U3.8 (6_OUT1D)
/STANDBY_GPS_MAX_7Q: J1.35 (GP19/SPI1_MISO), U3.6 (4_BCLK2)
/TX: J1.10 (TXD), U3.20 (28_RX7)
/VBAT: J4.2, U3.50 (VBAT)
/VBUS: J2.1 (USB_PWR), J3.2
GND: C1.1, C2.2, C8.1, C10.2, J1.6 (GND), J1.9 (GND), J1.14 (GND), J1.20 (GND), J1.25 (GND), J1.30 (GND), J1.34 (GND), J1.39 (GND), J2.5 (GND), J2.7 (GND), J3.1, J4.1, J5.1, U3.1 (GND), U3.34 (GND), U3.47 (GND), U3.52 (GND), U3.64 (GND)
