DJTobias/UAS_receiver_design/receiverV5/receiverV5.kicad_pcb

## KiCad design receiverV5/receiverV5.kicad_pcb (continued)

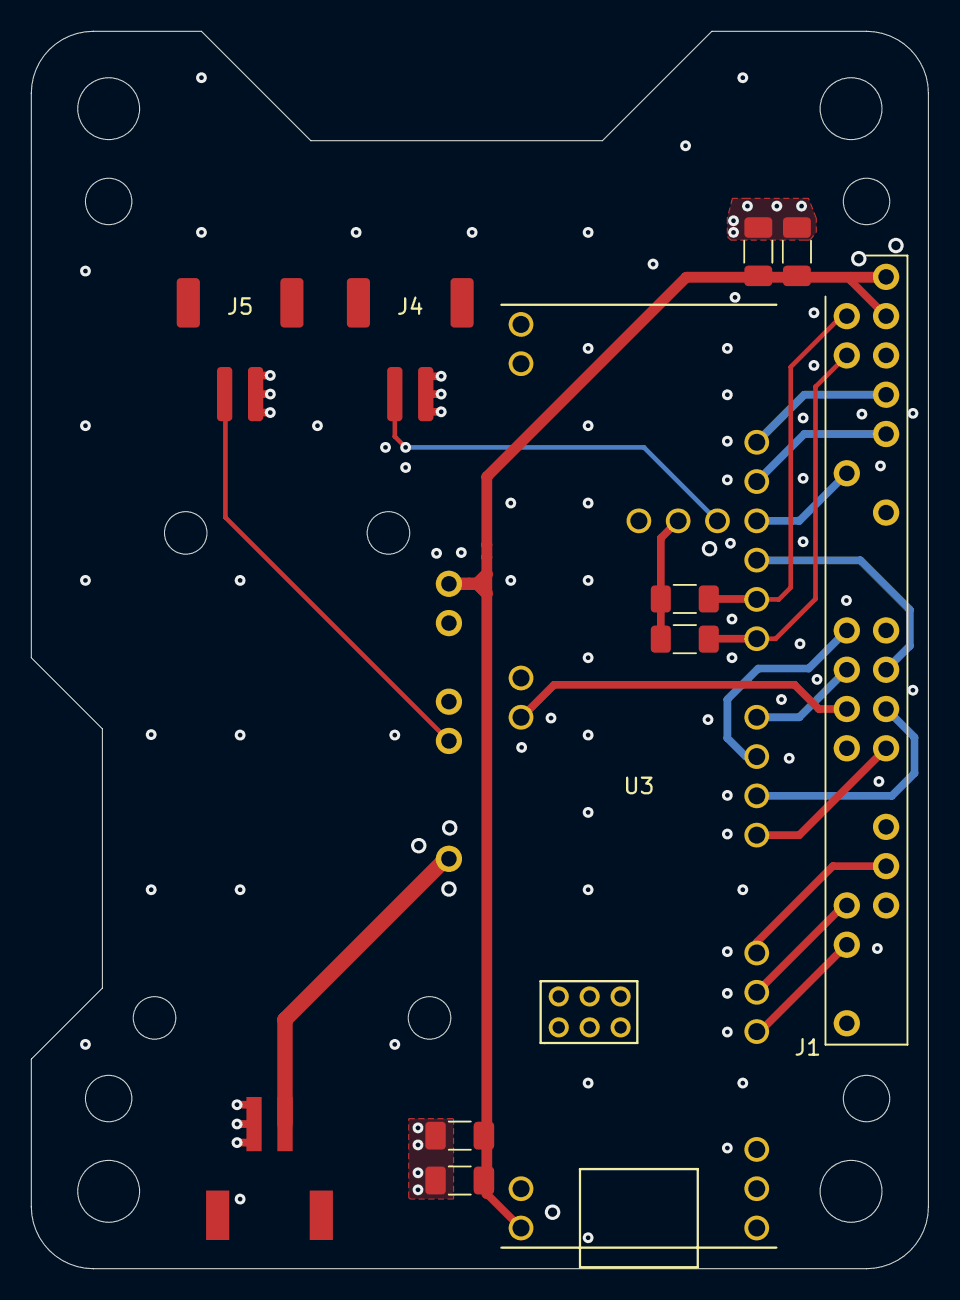
[picture p24: board receiverV5.kicad_pcb from above]

Board: 4 copper layers, 58.0 x 80.0 mm, 20 parts (0 on the bottom side), 20 nets.
