DJTobias/UAS_receiver_design/receiverV2/receiverV2.kicad_pcb

## KiCad design receiverV2/receiverV2.kicad_pcb (2025-05-28, an earlier design)

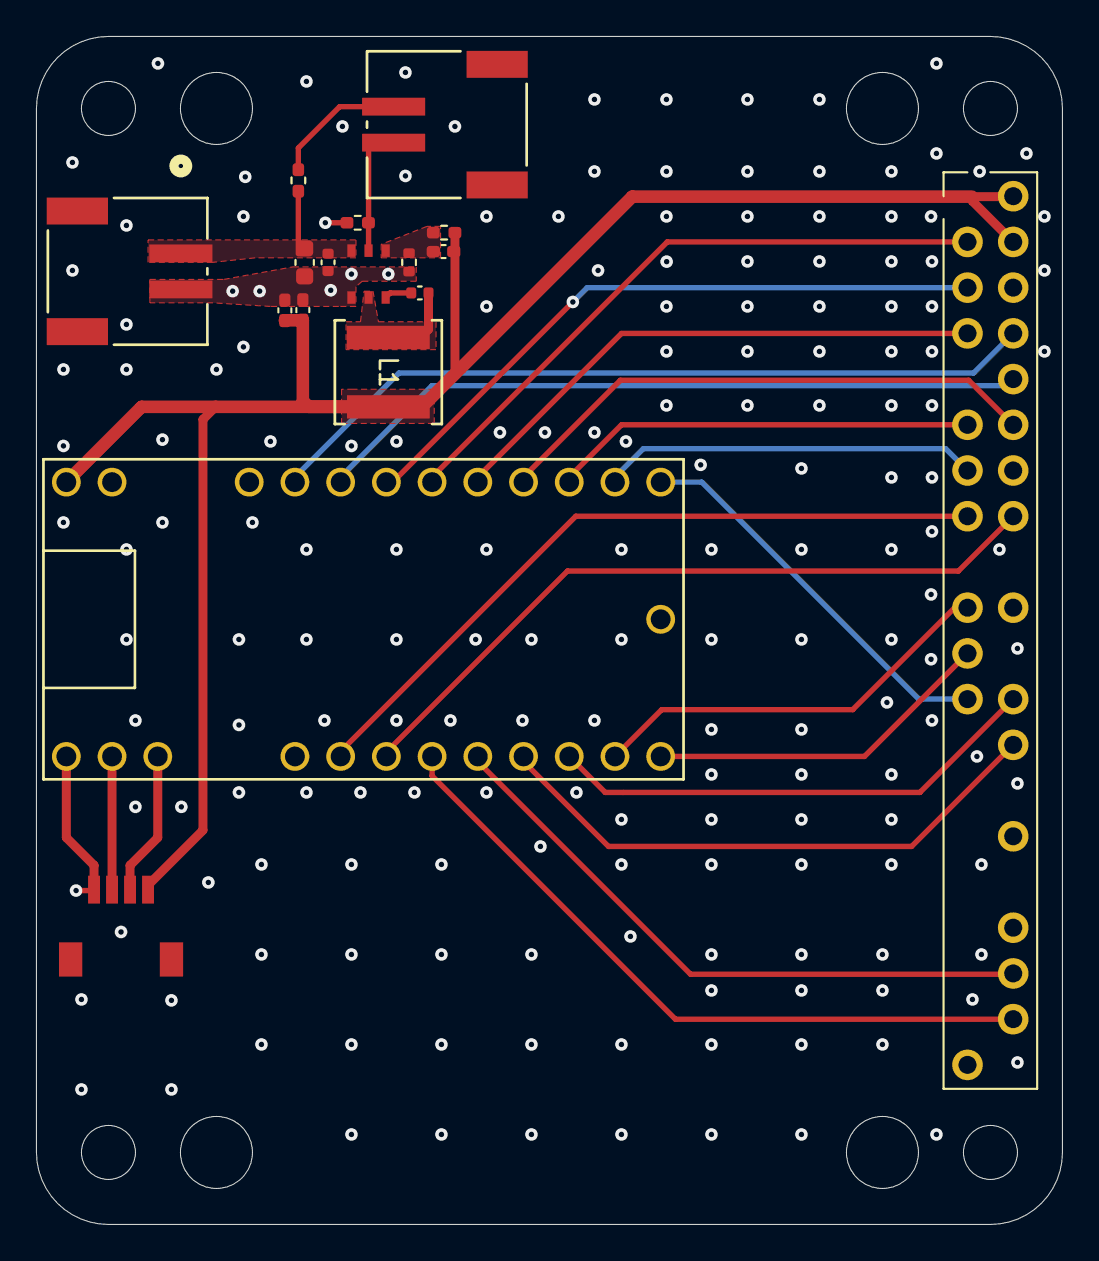
[picture p25: board receiverV2.kicad_pcb from above]

Board: 4 copper layers, 57.0 x 66.0 mm, 25 parts (0 on the bottom side), 27 nets.

Parts:
C1: 10u; C_0603_1608Metric
C2, C3: 100n; C_0402_1005Metric
C4, C5: 22u; C_0402_1005Metric_Pad0.74x0.62mm_HandSolder
C6: 47p; C_0402_1005Metric_Pad0.74x0.62mm_HandSolder
H1, H2, H3, H4: MountingHole; MountingHole_3mm_rec
H5, H6, H7, H8: MountingHole; MountingHole_4mm_t4
J1: Raspberry_Pi_4; PinHeader_2x20_P2.54mm_Vertical_receiver
J2: SM04B-SRSS-TB; CONN_SM04B-SRSS-TB_JST
J3: S2B-PH-SM4-TB; CONN_S2B-PH-SM4-TB_JST
L1: 6.8uH; IND_SRP5050FA-5R6M_BRN_mod
On/Off/switch1: S2B-PH-SM4-TB; CONN_S2B-PH-SM4-TB_JST_no_circle
R1, R2: 100k; R_0402_1005Metric_Pad0.72x0.64mm_HandSolder
R3: 162k; R_0402_1005Metric_Pad0.72x0.64mm_HandSolder
R4: 31.1k; R_0402_1005Metric
U1: Teensy4.0; Teensy40_receiver
U2: AP63300WU-7_mod; SOIC_05WU-7_DIO-L_mod

Connections:
+5V: C4.1, C5.1, C6.2, J1.2 (5V), J1.4 (5V), J2.4, L1.2, R3.2, U1.33 (VIN)
/BUSY: J1.7 (DP4), U1.24 (17_A3_TX4_SDA1)
/CS0: J1.24 (D8/SPI0_CS0), U1.12 (10_CS_MQSR)
/CS1: J1.26 (DP7/SPI0_CS1), U1.11 (9_OUT1C)
/DC-DC-Out: C3.2, L1.1, U2.5 (SW)
/DIO1: J1.11 (DP17), U1.22 (15_A1_RX3_SPDIF_IN)
/Enable: On/Off/switch1.1, R1.1, U2.2 (EN)
/FB: C6.1, R3.1, R4.1, U2.1 (FB)
/GPS_STBY: J1.13 (DP27), U1.21 (14_A0_TX3_SPDIF_OUT)
/LO_RST: J1.15 (DP22), U1.7 (5_IN2)
/MISO: J1.21 (DP9/SPI0_MISO), U1.14 (12_MISO_MQSL)
/MOD_6_MULT: J1.38 (DP20/SPI1_MOSI), U1.9 (7_RX2_OUT1A)
/MOD_8_MULT: J1.36 (DP16/SPI1_CS0), U1.10 (8_TX2_IN1)
/MOD_RST: J1.16 (D23), U1.8 (6_OUT1D)
/MOSI: J1.19 (DP10/SPI0_MOSI), U1.13 (11_MOSI_CTX1)
/RAD_PWR: J1.12 (D18), U1.23 (16_A2_RX4_SCL1)
/RX: J1.8 (RXD), U1.28 (21_A7_RX5_BCLK1)
/RX_ALT: J2.2, U1.2 (0_RX1_CRX2_CS1)
/SCK: J1.23 (DP9/SPI0_SCLK), U1.20 (13_SCK_CRX1_LED)
/SCL: J1.5 (DP3/SCL), U1.26 (19_A5_SCL0)
/SDA: J1.3 (DP2/SDA), U1.25 (18_A4_SDA0)
/TX: J1.10 (TXD), U1.27 (20_A6_TX5_LRCLK1)
/TX_ALT: J2.3, U1.3 (1_TX1_CTX2_MISO1)
GND: C1.2, C2.2, C4.2, C5.2, J1.6 (GND), J1.14 (GND), J1.20 (GND), J1.30 (GND), J1.34 (GND), J1.39 (GND), J2.1, J3.2, R1.2, R4.2, U1.1 (GND), U1.17 (GND), U1.32 (GND), U2.4 (GND)
unnamed: On/Off/switch1.2, R2.1
unnamed: C3.1, U2.6 (BST)
VBUS: C1.1, C2.1, J3.1, R2.2, U2.3 (VIN)
