DJTobias/UAS_receiver_design/(commit log)

2024-12-05 add receiver kicad files
    [receiverV2.kicad_pcb, receiverV2.kicad_sch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]
2025-05-28 add teensy4.1 version of receiver
    [receiverV2.kicad_pcb, receiverV3.kicad_pcb, receiverV3.kicad_sch, receiverv4_eth.kicad_pcb, receiverv4_eth.kicad_sch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]
2025-07-23 update receiver repo
    [receiverV5.kicad_pcb, receiverV5.kicad_sch, receiverV6.kicad_pcb, receiverV6.kicad_sch, receiverv5_eth.kicad_pcb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]
2025-08-22 add rp2350 design
    [RP2350_60QFN_minimal.kicad_pcb, RP2350_60QFN_minimal.kicad_sch, receiver7RP2350.kicad_pcb, receiver7RP2350.kicad_sch, receiver7RP2350V2.kicad_pcb, receiver7RP2350V2.kicad_sch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]
2025-08-27 add rp2350V2
    [receiver7RP2350V2.kicad_pcb, receiver7RP2350V2.kicad_sch]
2025-09-25 add panelized files
    [Receiver RP2350V2.xlsx, panel2.kicad_pcb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]
2025-09-27 update to schematic
    [receiver7RP2350V2.kicad_sch]
2025-10-08 updates to receiver layout
    [receiver7RP2350V2.kicad_pcb, receiver7RP2350V2.kicad_sch]
2025-10-22 add pdf of design and changes to board
    [receiver7RP2350V2.kicad_pcb]
2026-02-13 add receiver V3 and V4
    [RP2350_60QFN_minimal.kicad_pcb, RP2350_60QFN_minimal.kicad_sch, Receiver RP2350V2.xlsx, panel2.kicad_pcb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]
2026-02-13 added changes to v4
    [receiver7RP2350V4.kicad_pcb]
2026-05-13 addev initial v5 version
    [R4_BOM.xlsx, RP2350_60QFN_minimal.kicad_pcb, RP2350_60QFN_minimal.kicad_sch, Receiver RP2350V2.xlsx, panel2.kicad_pcb, receiver7RP2350V4.kicad_pcb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]
2026-05-14 working drc for v5
    [receiver7RP2350V5.kicad_pcb]
